brennanMKE/TeaLight/tea-light/production/tea-light-bottom.png

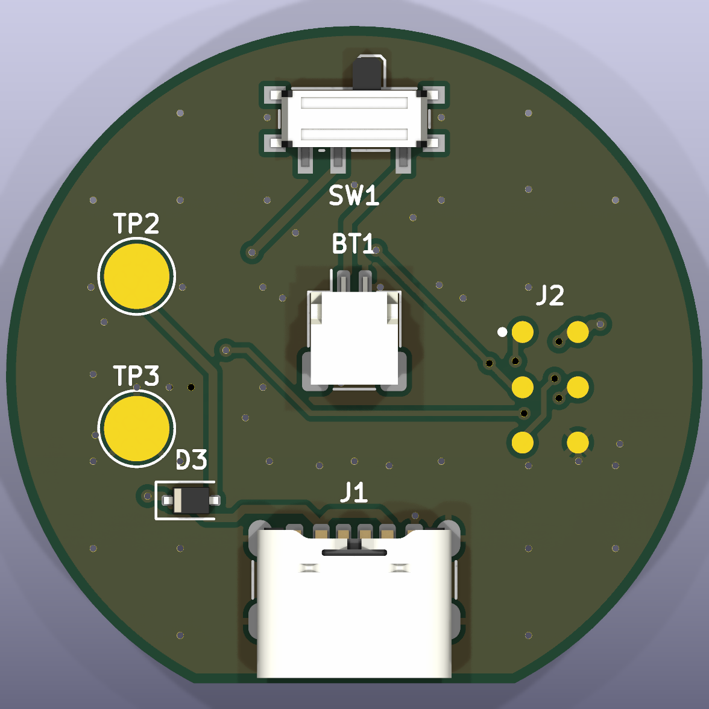
tea-light/production/tea-light-bottom.png
