brennanMKE/TeaLight/tea-light/production/tea-light-bom-jlcpcb.csv

Comment | Designator | Footprint | LCSC Part #
LiPo 1S 150mAh w/ PCM | BT1 | Connector_JST:JST_SH_SM02B-SRSS-TB_1x02-1MP_P1.00mm_Horizontal | C160402
4.7u | C1,C2,C4 | Capacitor_SMD:C_0603_1608Metric | C19666
100n | C3 | Capacitor_SMD:C_0402_1005Metric | C1525
LED warm white | D1,D2 | LED_SMD:LED_0603_1608Metric
BAT54J | D3 | Diode_SMD:D_SOD-323F | C130415
USB-C PWR 6P | J1 | Connector_USB:USB_C_Receptacle_GCT_USB4125-xx-x_6P_TopMnt_Horizontal
5.1k | R1,R2 | Resistor_SMD:R_0402_1005Metric | C25905
10k | R3,R4 | Resistor_SMD:R_0402_1005Metric | C25744
100 | R5 | Resistor_SMD:R_0402_1005Metric | C25076
150 | R6,R7 | Resistor_SMD:R_0402_1005Metric | C25082
SW_SPDT | SW1 | Button_Switch_SMD:SW_SPDT_PCM12 | C221841
ATtiny85-20SU | U1 | Package_SO:SOIC-8_5.3x5.3mm_P1.27mm | C31540447
MCP73831T-2ACI/OT | U2 | Package_TO_SOT_SMD:SOT-23-5 | C424093
TSOP75238TT | U3 | tea-light:Vishay_Heimdall_TSOP752xx_TT_TopView | C5248434
