brennanMKE/TeaLight/tea-light/tea-light.kicad_pcb

## KiCad design tea-light/tea-light.kicad_pcb (2026-11-08)

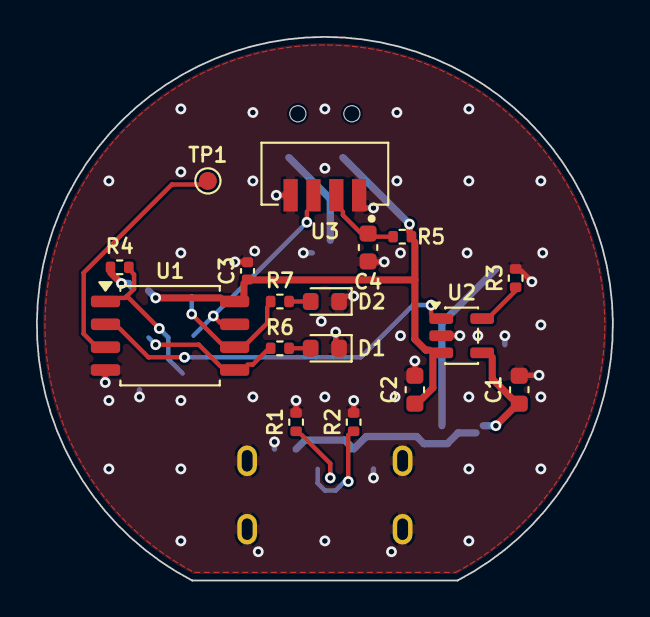
[picture p3: board tea-light.kicad_pcb from above]

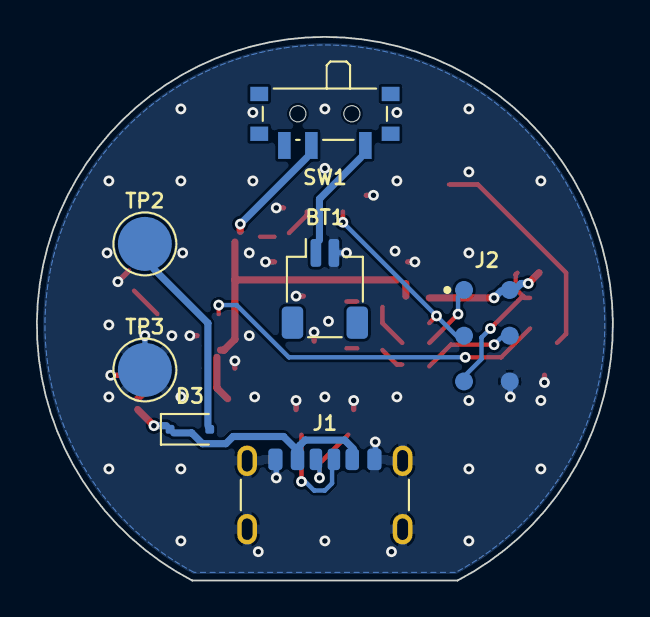
[picture p4: board tea-light.kicad_pcb from below]

Board: 2 copper layers, 32.0 x 30.2 mm, 24 parts (7 on the bottom side), 17 nets.

Parts:
BT1: LiPo 1S 150mAh w/ PCM; JST_SH_SM02B-SRSS-TB_1x02-1MP_P1.00mm_Horizontal
C1, C2, C4: 4.7u; C_0603_1608Metric
C3: 100n; C_0402_1005Metric
D1, D2: LED warm white; LED_0603_1608Metric
D3: BAT54J; D_SOD-323F
J1: USB-C PWR 6P; USB_C_Receptacle_GCT_USB4125-xx-x_6P_TopMnt_Horizontal
J2: ISP; ISP_Pogo_2x03_P2.54mm_Pad1.0mm
R1, R2: 5.1k; R_0402_1005Metric
R3, R4: 10k; R_0402_1005Metric
R5: 100; R_0402_1005Metric
R6, R7: 150; R_0402_1005Metric
SW1: SW_SPDT; SW_SPDT_PCM12
TP1: PB4_SPARE; TestPoint_Pad_D1.0mm
TP2: TRAY_VBUS; TestPoint_Pad_D3.0mm
TP3: TRAY_GND; TestPoint_Pad_D3.0mm
U1: ATtiny85-20SU; SOIC-8_5.3x5.3mm_P1.27mm
U2: MCP73831T-2ACI/OT; SOT-23-5
U3: TSOP75238TT; Vishay_Heimdall_TSOP752xx_TT_TopView

Connections:
BAT_P: BT1.1, SW1.1
CC1: J1.A5, R1.1
CC2: J1.B5, R2.1
GND: BT1.2, C1.2, C2.2, C3.2, C4.2, D1.1, D2.1, J1.A12, J1.B12, J1.SH, J2.6, R1.2, R2.2, R3.2, TP3.1, U1.4, U2.2, U3.1, U3.4
IR_OUT: J2.3, U1.7, U3.3
IR_VS: C4.1, R5.2, U3.2
LED1: J2.4, R6.1, U1.5
LED1_A: D1.2, R6.2
LED2: J2.1, R7.1, U1.6
LED2_A: D2.2, R7.2
PROG: R3.1, U2.5
RESET: J2.5, R4.2, U1.1
SPARE: TP1.1, U1.3
STAT: U1.2, U2.1
TRAY_VBUS: D3.2, TP2.1
VBAT: C2.1, C3.1, J2.2, R4.1, R5.1, SW1.2, U1.8, U2.3
VBUS: C1.1, D3.1, J1.A9, J1.B9, U2.4
