brennanMKE/TeaLight/(commit log)

2026-11-08 Add design spec, schematic SVG, README, and git config
2026-11-08 Add KiCad project: schematic, routed 32 mm PCB, JLCPCB outputs
    - Schematic from the design spec (ERC clean), with project symbol and
    footprint for the TSOP75238TT and a 2x3 pogo ISP pad footprint
    - PCB generated by scripts/build_board.py with a small maze router;
    DRC clean against JLCPCB-oriented rules stored in the project
    - LCSC part numbers mapped; Gerber zip, JLCPCB BOM/CPL and renders in
    tea-light/production via scripts/export_fab.sh
    [tea-light-bom-jlcpcb.csv, tea-light.kicad_pcb, tea-light.kicad_sch, visual-diff-0b8289ce2dfb35e3-before.kicad_sch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]
2026-11-08 Ignore KiCad MCP cache directory
    [visual-diff-0b8289ce2dfb35e3-before.kicad_sch]
